evolutek/acdc/V1/Mechanic/Raspy Cam/27-1a.stp

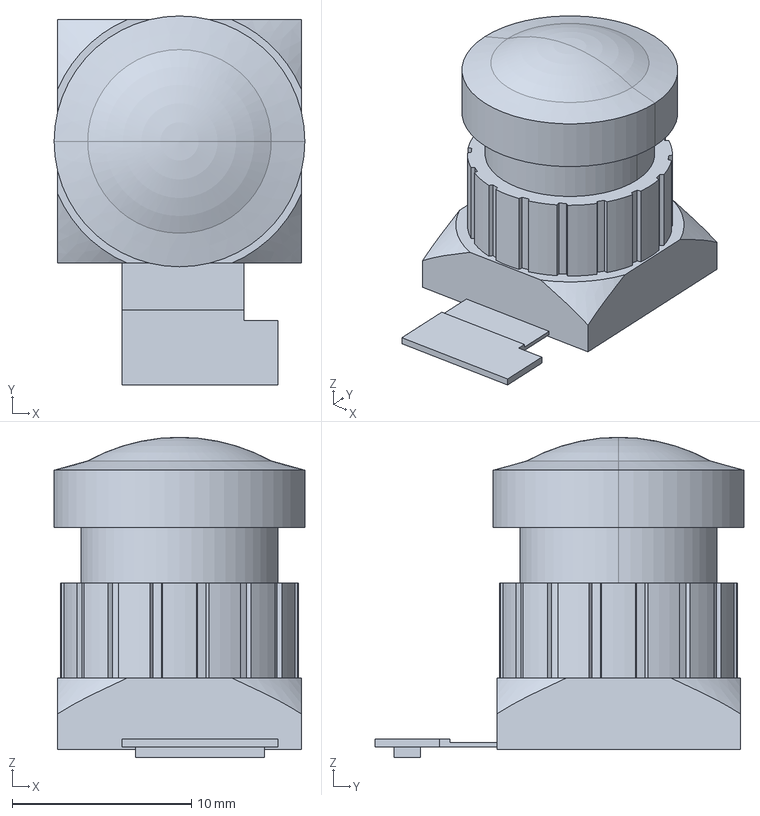
[picture p1: CAD file, 2023-09-23, an earlier design]
V1/Mechanic/Raspy Cam/27-1a.stp
14.0 x 20.6 x 17.9 mm
