evolutek/acdc/(list of files, cad)

Other CAD files:
V1/Mechanic/Camera GYTCARS.CATProduct
V1/Mechanic/Mainboard GYTCARS.CATProduct
V1/Mechanic/Mainboard/COMPOUND_1.CATPart
V1/Mechanic/Mainboard/COMPOUND_4.CATPart
V1/Mechanic/Mainboard/Mainboard GYTCARS V1.CATProduct
V1/Mechanic/Mainboard/SOLID.CATPart
V1/Mechanic/Mainboard/SOLID_1.CATPart
V1/Mechanic/Mainboard/SOLID_10.CATPart
V1/Mechanic/Mainboard/SOLID_11.CATPart
V1/Mechanic/Mainboard/SOLID_12.CATPart
V1/Mechanic/Mainboard/SOLID_2.CATPart
V1/Mechanic/Mainboard/SOLID_3.CATPart
V1/Mechanic/Mainboard/SOLID_4.CATPart
V1/Mechanic/Mainboard/SOLID_5.CATPart
V1/Mechanic/Mainboard/SOLID_6.CATPart
V1/Mechanic/Mainboard/SOLID_7.CATPart
V1/Mechanic/Mainboard/SOLID_8.CATPart
V1/Mechanic/Mainboard/SOLID_9.CATPart
V1/Mechanic/Raspy Cam/27-1.CATPart
V1/Mechanic/Raspy Cam/4pin_smd.CATPart
V1/Mechanic/Raspy Cam/70521906_01.CATPart
V1/Mechanic/Raspy Cam/70521906_02.CATPart
V1/Mechanic/Raspy Cam/70521906_03.CATPart
V1/Mechanic/Raspy Cam/70521906_04.CATPart
V1/Mechanic/Raspy Cam/70521906_05.CATPart
V1/Mechanic/Raspy Cam/70521906_06.CATPart
V1/Mechanic/Raspy Cam/70521906_07.CATPart
V1/Mechanic/Raspy Cam/CAPC-0402-T0.55-BN.CATPart
V1/Mechanic/Raspy Cam/CAPC-0805-T0.75-BN.CATPart
V1/Mechanic/Raspy Cam/CCD.CATPart
V1/Mechanic/Raspy Cam/KX7 SMD Quartz Crystal Resonator 3.2x2.5mm.CATPart
V1/Mechanic/Raspy Cam/OVA5647_Housing.CATPart
V1/Mechanic/Raspy Cam/OVA5647_Lens_FOV.CATPart
V1/Mechanic/Raspy Cam/PicameraPCB.CATPart
V1/Mechanic/Raspy Cam/RESC-0402.CATPart
V1/Mechanic/Raspy Cam/RESC-0603.CATPart
V1/Mechanic/Raspy Cam/RESC-1210.CATPart
V1/Mechanic/Raspy Cam/RspCameraMia.CATProduct
V1/Mechanic/Raspy Cam/SOT23-5.CATPart
V1/Mechanic/Raspy Cam/c-1-1734248-5-e-raspberry_display.CATPart
V1/Mechanic/Raspy Cam/c6aaa.CATPart
V1/Mechanic/Raspy Cam/ribbon_cam.CATPart
V1/Mechanic/Support Camera GYTCARS.CATPart
