evolutek/acdc/V2/DevBoard/Output/Schematics.pdf

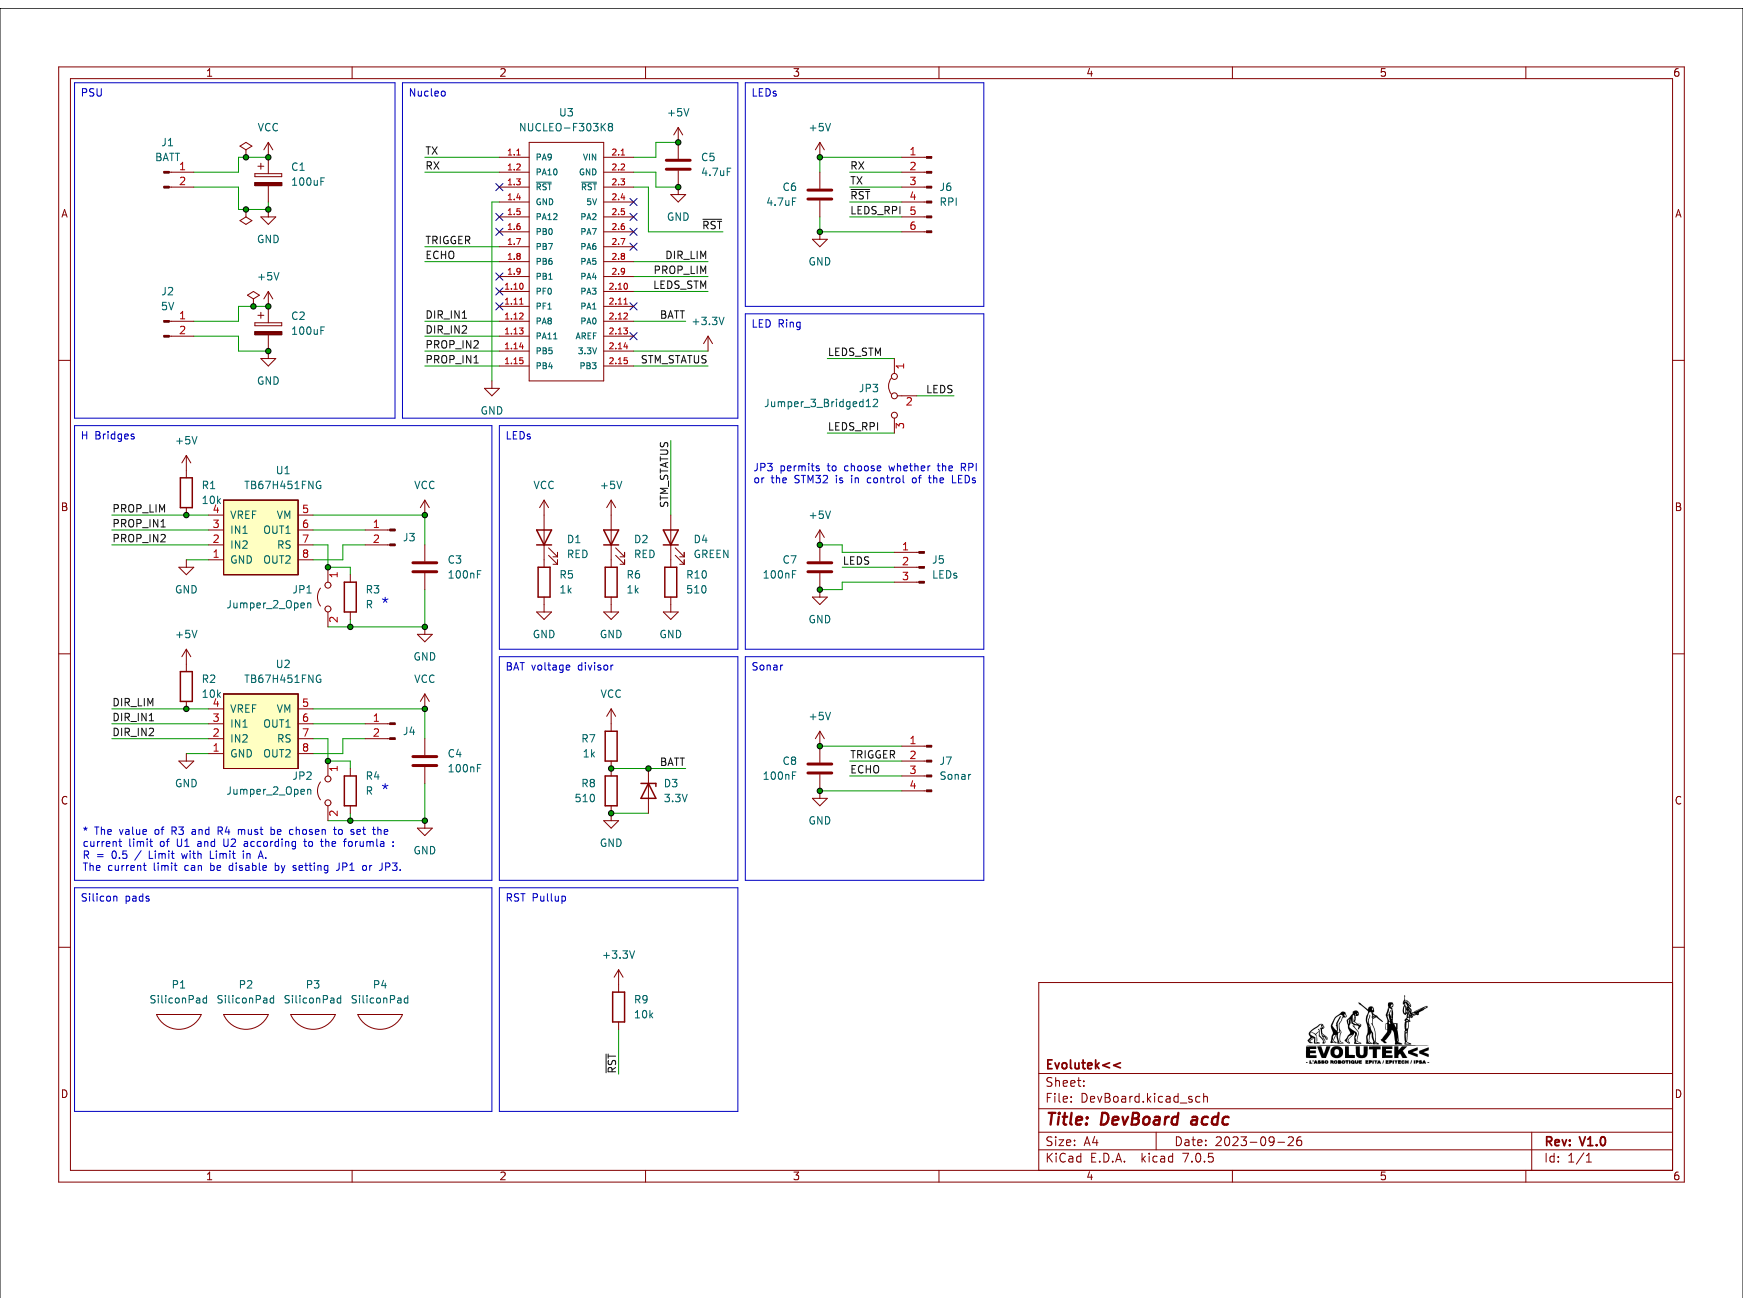
[picture p3: page 1]
