evolutek/acdc/V2/DevBoard/Output/Board-Front.pdf

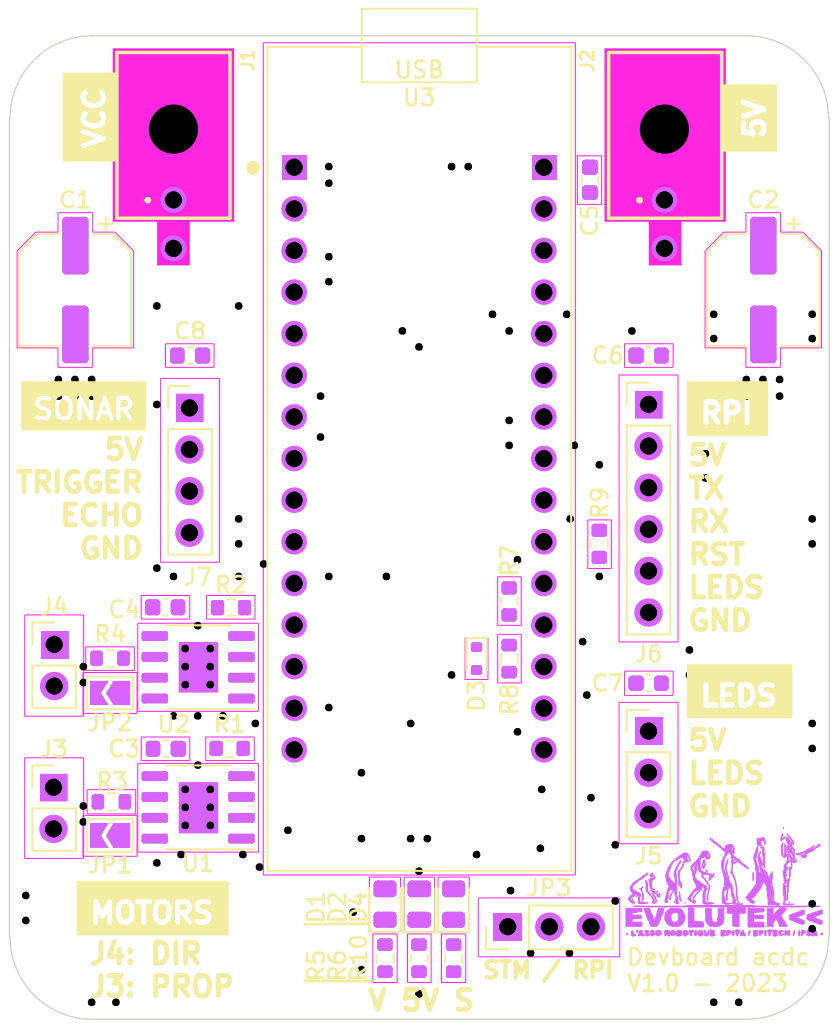
[picture p4: page 1]
