evolutek/acdc/V1/Board/Output/Schematics.pdf

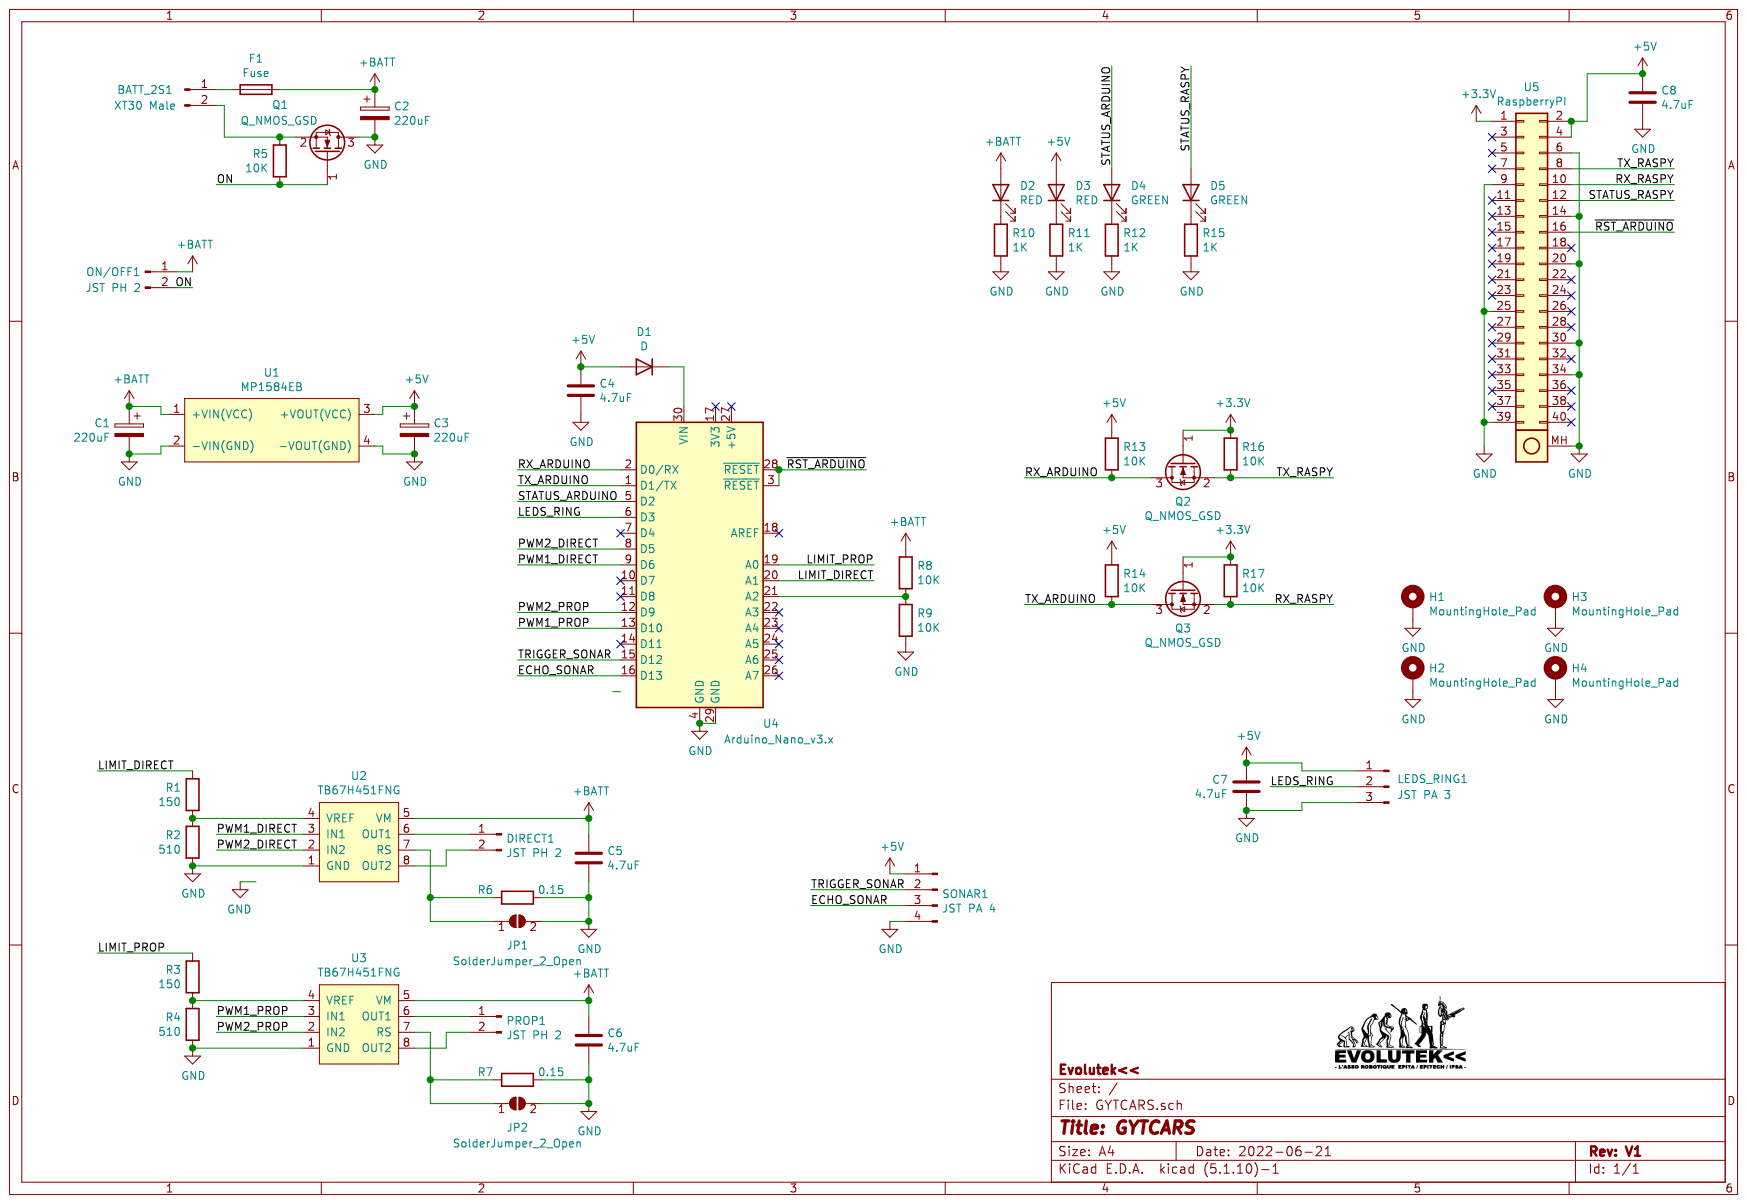
[picture p5: page 1]
