evolutek/acdc/V1/Board/Output/Board-Back.pdf

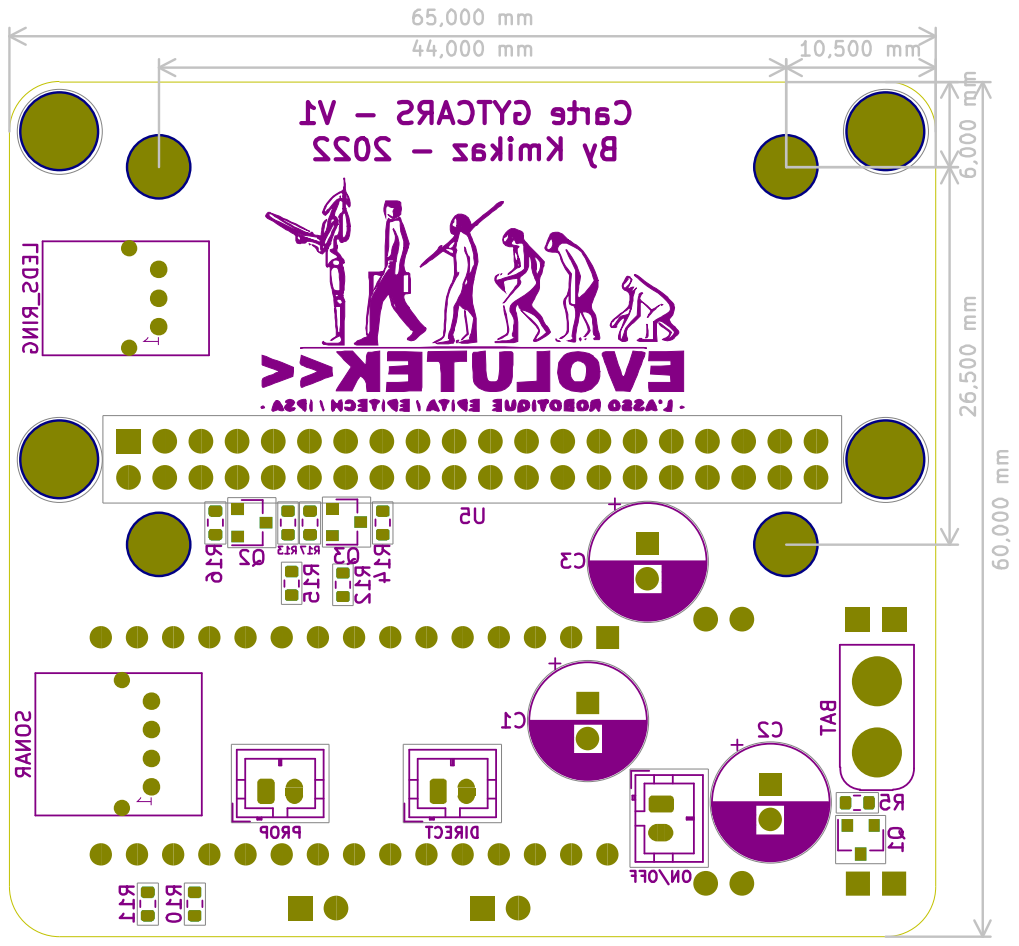
[picture p6: page 1]
