evolutek/acdc/V1/Board/Output/Board-Front.pdf

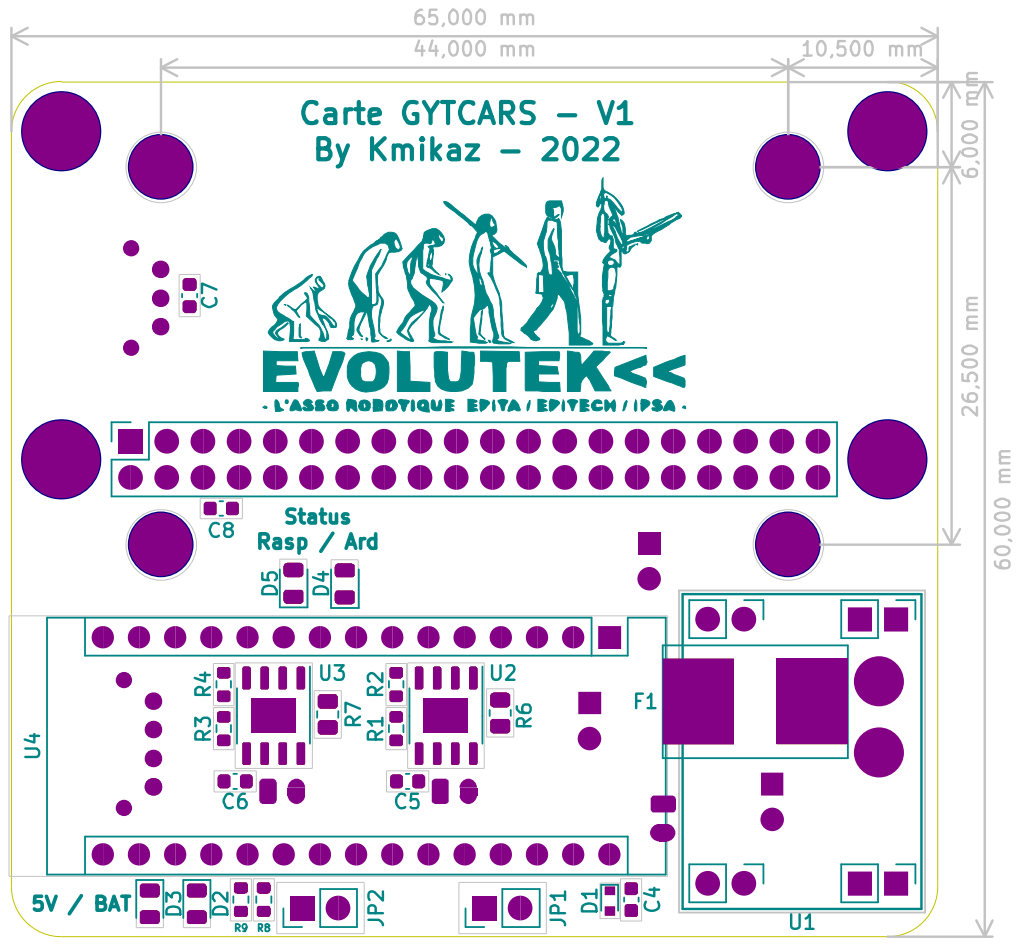
[picture p7: page 1]
