evolutek/acdc/V2/DevBoard/DevBoard.kicad_pcb

## KiCad design V2/DevBoard/DevBoard.kicad_pcb (2023-10-06)

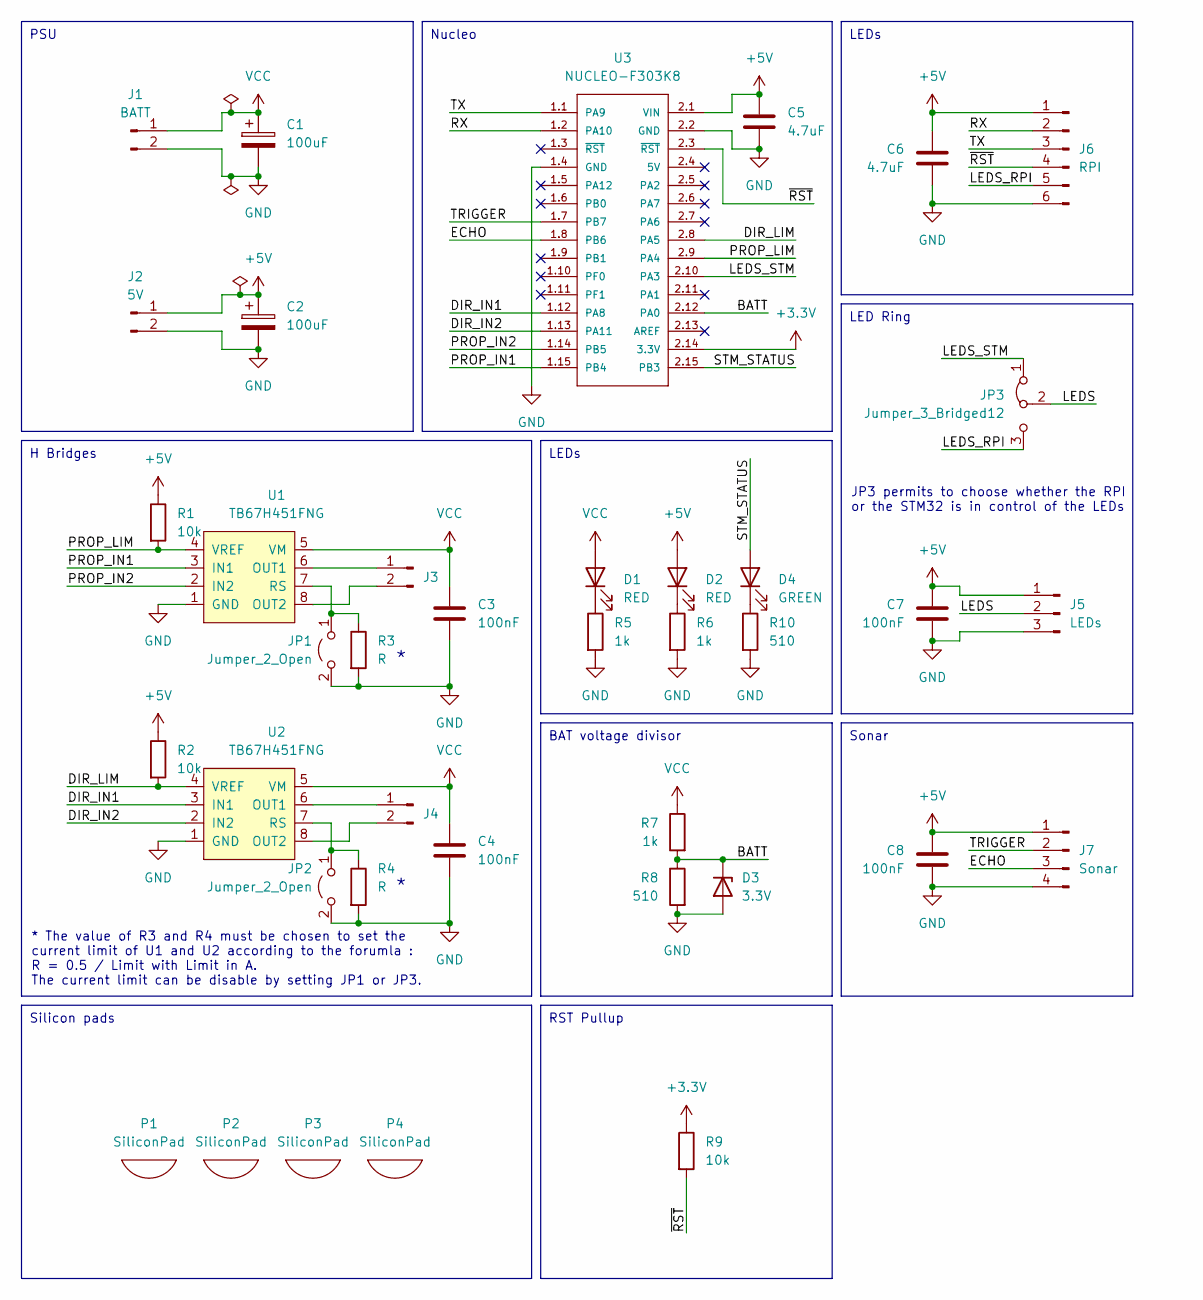
[picture p8: schematic DevBoard.kicad_sch, DevBoard acdc]

Parts:
C1, C2: 100uF; CP_Elec_6.3x7.7
C3, C4, C7, C8: 100nF; C_0603_1608Metric
C5, C6: 4.7uF; C_0603_1608Metric
D1, D2: RED; LED_0805_2012Metric
D3: 3.3V; D_SOD-523
D4: GREEN; LED_0805_2012Metric
J1: BATT; 66200221022
J2: 5V; 66200221022
J3, J4: Conn_01x02_Pin; PinHeader_1x02_P2.54mm_Vertical
J5: LEDs; PinHeader_1x03_P2.54mm_Vertical
J6: RPI; PinHeader_1x06_P2.54mm_Vertical
J7: Sonar; PinHeader_1x04_P2.54mm_Vertical
JP1, JP2: Jumper_2_Open; SolderJumper-2_P1.3mm_Open_TrianglePad1.0x1.5mm
JP3: Jumper_3_Bridged12; PinHeader_1x03_P2.54mm_Vertical
P1, P2, P3, P4: SiliconPad; Silicon Pad 6x2mm
R1, R2, R9: 10k; R_0603_1608Metric
R3, R4: R; R_0603_1608Metric
R5, R6, R7: 1k; R_0603_1608Metric
R8, R10: 510; R_0603_1608Metric
U1, U2: TB67H451FNG; HSOP-8-1EP_3.9x4.9mm_P1.27mm_EP2.41x3.1mm_ThermalVias
U3: NUCLEO-F303K8; MODULE_NUCLEO-F303K8

Connections:
+3.3V: R9.1, U3.2.14 (3.3V)
+5V: C2.1, C5.1, C6.1, C7.1, C8.1, D2.2 (A), J2.1, J5.1, J6.1, J7.1, R1.1, R2.1, U3.2.1 (VIN)
/BATT: D3.1 (K), R7.2, R8.1, U3.2.12 (PA0)
/DIR_IN1: U2.3 (IN1), U3.1.12 (PA8)
/DIR_IN2: U2.2 (IN2), U3.1.13 (PA11)
/DIR_LIM: R2.2, U2.4 (VREF), U3.2.8 (PA5)
/ECHO: J7.3, U3.1.8 (PB6)
/LEDS: J5.2, JP3.2 (C)
/LEDS_RPI: J6.5, JP3.3 (B)
/LEDS_STM: JP3.1 (A), U3.2.10 (PA3)
/PROP_IN1: U1.3 (IN1), U3.1.15 (PB4)
/PROP_IN2: U1.2 (IN2), U3.1.14 (PB5)
/PROP_LIM: R1.2, U1.4 (VREF), U3.2.9 (PA4)
/RX: J6.2, U3.1.2 (PA10)
/STM_STATUS: D4.2 (A), U3.2.15 (PB3)
/TRIGGER: J7.2, U3.1.7 (PB7)
/TX: J6.3, U3.1.1 (PA9)
/~RST: J6.4, R9.2, U3.2.3 (~RST)
GND: C1.2, C2.2, C3.2, C4.2, C5.2, C6.2, C7.2, C8.2, D3.2 (A), J1.2, J2.2, J5.3, J6.6, J7.4, JP1.2 (B), JP2.2 (B), R3.2, R4.2, R5.2, R6.2, R8.2, R10.2, U1.1 (GND), U2.1 (GND), U3.1.4 (GND), U3.2.2 (GND)
unnamed: D1.1 (K), R5.1
unnamed: D2.1 (K), R6.1
unnamed: D4.1 (K), R10.1
unnamed: J3.1, U1.6 (OUT1)
unnamed: J3.2, U1.8 (OUT2)
unnamed: J4.1, U2.6 (OUT1)
unnamed: J4.2, U2.8 (OUT2)
unnamed: JP1.1 (A), R3.1, U1.7 (RS)
unnamed: JP2.1 (A), R4.1, U2.7 (RS)
VCC: C1.1, C3.1, C4.1, D1.2 (A), J1.1, R7.1, U1.5 (VM), U2.5 (VM)

Notes on the sheet:
LEDs
H Bridges
Sonar
PSU
Silicon pads
Nucleo
BAT voltage divisor
LED Ring
RST Pullup
JP3 permits to choose whether the RPI or the STM32 is in control of the LEDs
* The value of R3 and R4 must be chosen to set the current limit of U1 and U2 according to the forumla : R = 0.5 / Limit with Limit in A. The current limit can be disable by setting JP1 or JP3.

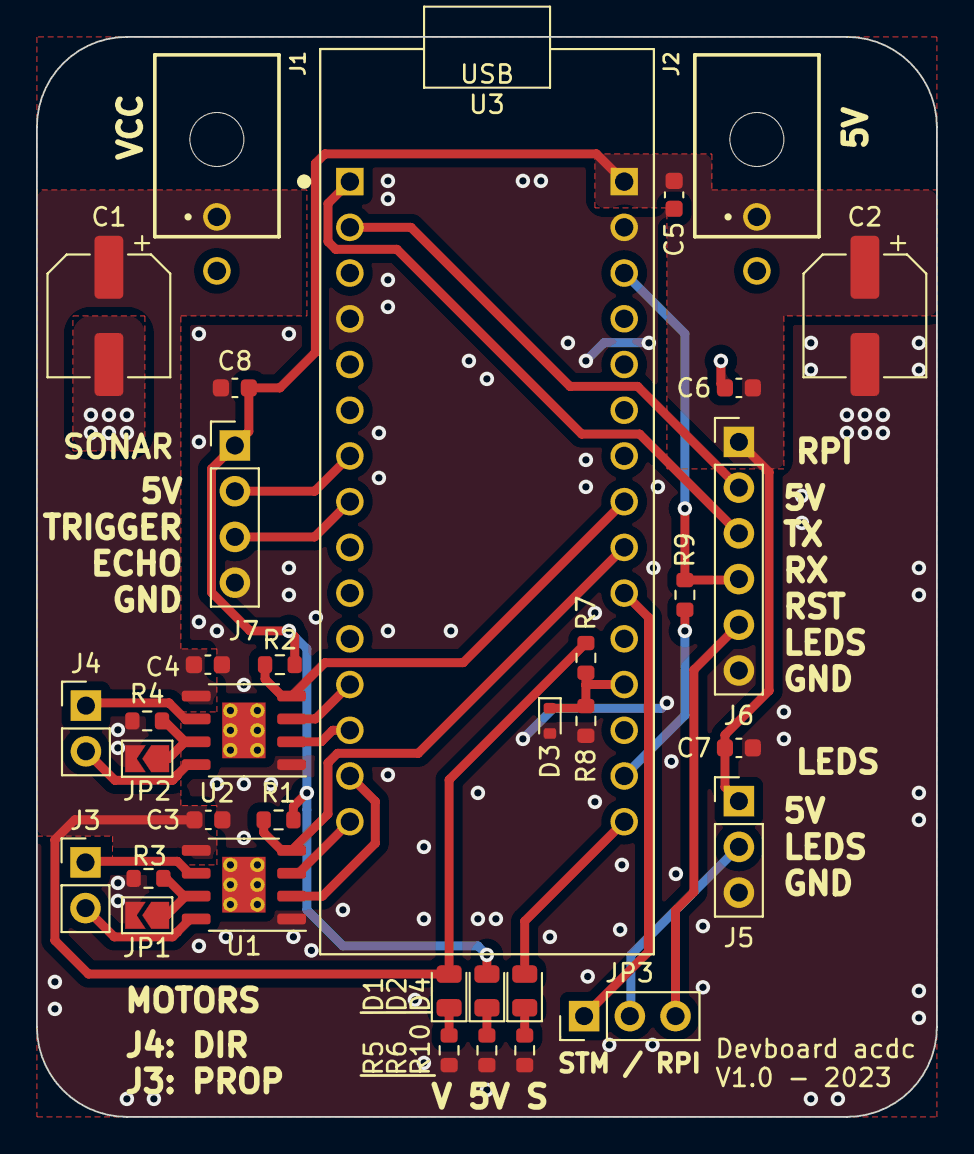
[picture p9: board DevBoard.kicad_pcb from above]

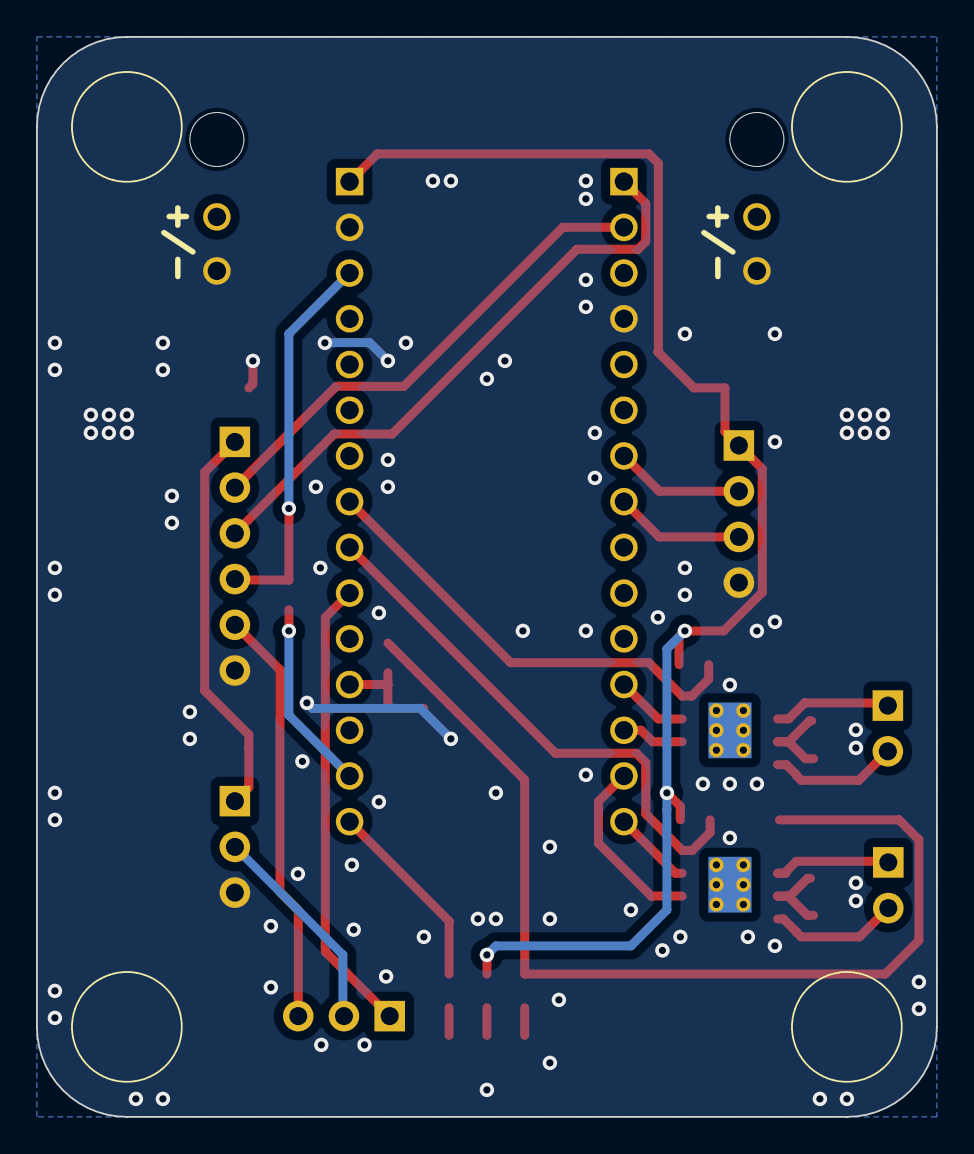
[picture p10: board DevBoard.kicad_pcb from below]

Board: 2 copper layers, 50.0 x 60.0 mm, 39 parts (4 on the bottom side), 29 nets.
