evolutek/acdc/V1/Board/GYTCARS.kicad_pcb

## KiCad design V1/Board/GYTCARS.kicad_pcb (2022-06-21, an earlier design)

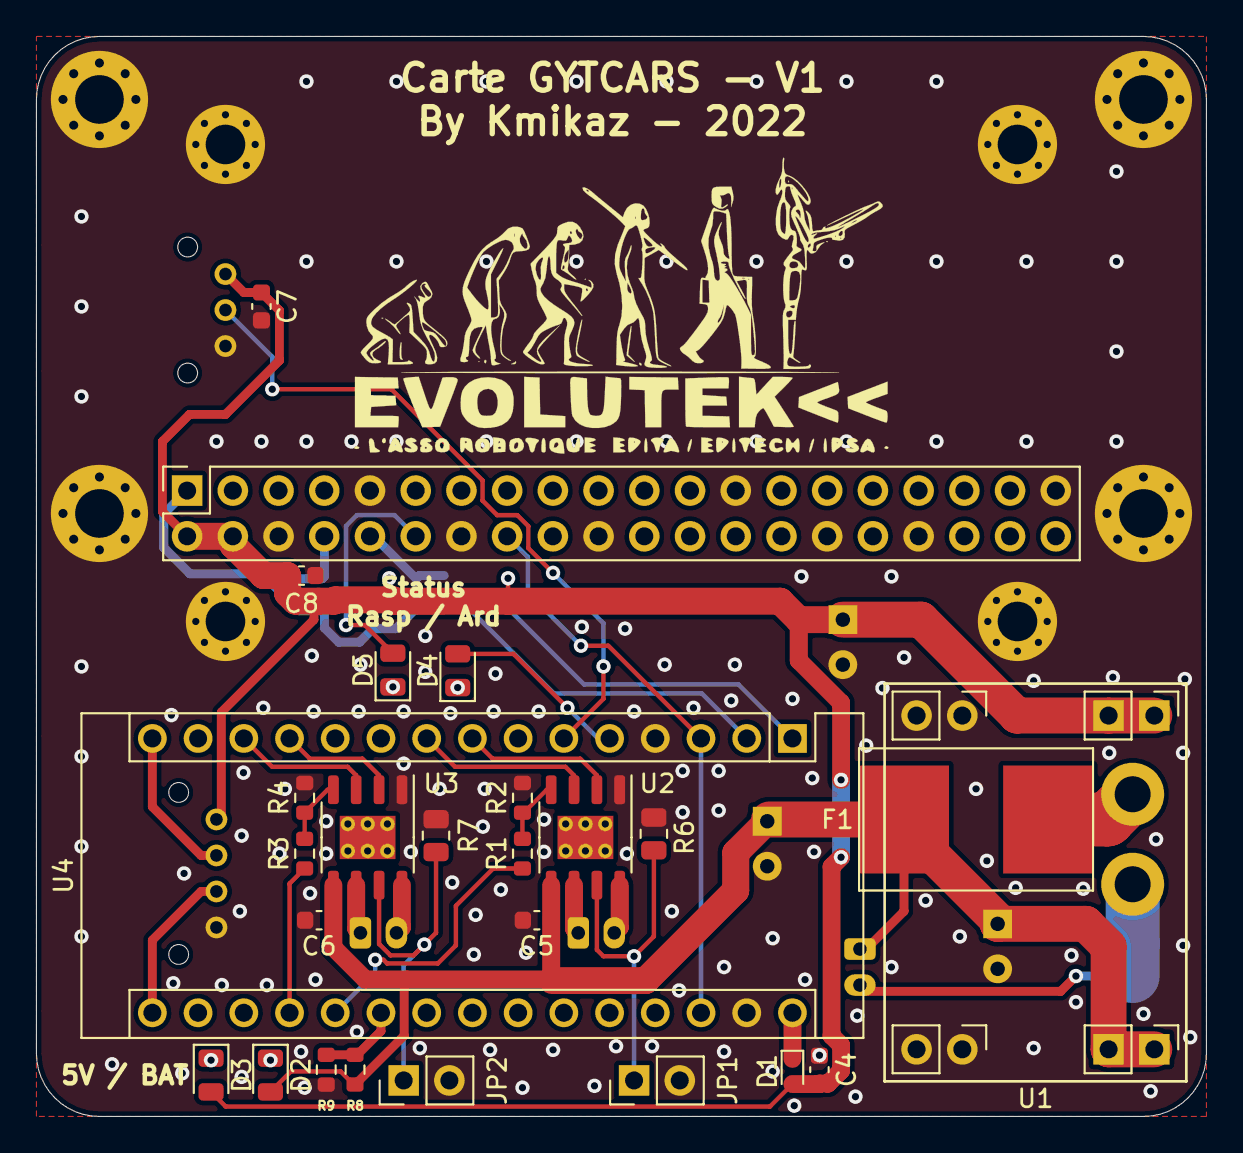
[picture p11: board GYTCARS.kicad_pcb from above]

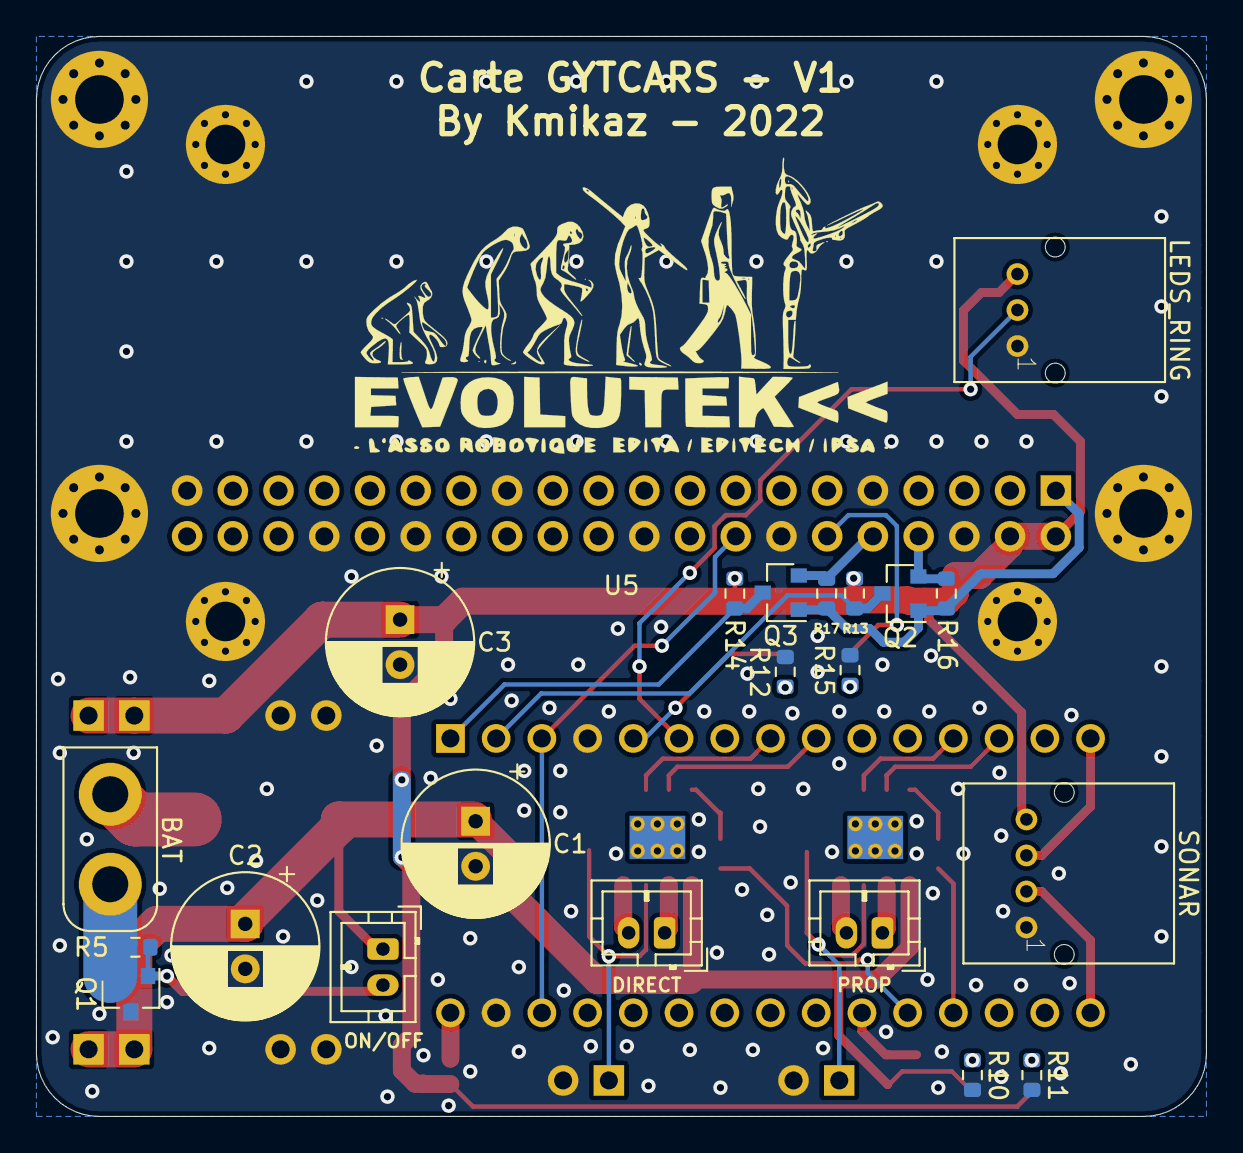
[picture p12: board GYTCARS.kicad_pcb from below]

Board: 2 copper layers, 65.0 x 60.0 mm, 51 parts (22 on the bottom side), 37 nets.

Parts:
BAT: XT30 Male; XT30
C1, C2, C3: 220uF; CP_Radial_D8.0mm_P2.50mm
C4, C5, C6, C7, C8: 4.7uF; C_0603_1608Metric
D1: D; D_SOD-523
D2, D3: RED; LED_0805_2012Metric
D4, D5: GREEN; LED_0805_2012Metric
DIRECT: JST PH 2; JST_PH_B2B-PH-K_1x02_P2.00mm_Vertical
F1: Fuse; 0031.7701.11
H1, H2, H3, H4: MountingHole_Pad; MountingHole_2.2mm_M2_Pad_Via
JP1, JP2: SolderJumper_2_Open; PinHeader_1x02_P2.54mm_Vertical
LEDS_RING: JST PA 3; S03B-PASK
ON/OFF: JST PH 2; JST_PH_B2B-PH-K_1x02_P2.00mm_Vertical
PROP: JST PH 2; JST_PH_B2B-PH-K_1x02_P2.00mm_Vertical
Q1, Q2, Q3: Q_NMOS_GSD; SOT-23
R1, R3: 150; R_0603_1608Metric
R2, R4: 510; R_0603_1608Metric
R5, R8, R9, R13, R14, R16, R17: 10K; R_0603_1608Metric
R6, R7: 0.15; R_0805_2012Metric
R10, R11, R12, R15: 1K; R_0603_1608Metric
SONAR: JST PA 4; S04B-PASK
U1: MP1584EB; MP1584EN
U2, U3: TB67H451FNG; HSOP-8-1EP_3.9x4.9mm_P1.27mm_EP2.41x3.1mm_ThermalVias
U4: Arduino_Nano_v3.x; ArduinoNano
U5: RaspberryPI; Shield_Raspberry_Pi_Zero_W

Connections:
+3V3: Q2.1, Q3.1, R16.1, R17.1, U5.1
+5V: C3.1, C4.1, C7.1, C8.1, D1.2, D3.2, LEDS_RING.1, R13.1, R14.1, SONAR.1, U1.3, U5.2, U5.4
+BATT: C1.1, C2.1, C5.1, C6.1, D2.2, F1.1, ON/OFF.1, R8.1, U1.1, U2.5, U3.5
/ECHO_SONAR: SONAR.3, U4.16
/LEDS_RING: LEDS_RING.2, U4.6
/LIMIT_DIRECT: R1.1, U4.20
/LIMIT_PROP: R3.1, U4.19
/ON: ON/OFF.2, Q1.1, R5.2
/PWM1_DIRECT: U2.3, U4.9
/PWM1_PROP: U3.3, U4.13
/PWM2_DIRECT: U2.2, U4.8
/PWM2_PROP: U3.2, U4.12
/RX_ARDUINO: Q2.3, R13.2, U4.2
/RX_RASPY: Q3.2, R17.2, U5.10
/STATUS_ARDUINO: D4.2, U4.5
/STATUS_RASPY: D5.2, U5.12
/TRIGGER_SONAR: SONAR.2, U4.15
/TX_ARDUINO: Q3.3, R14.2, U4.1
/TX_RASPY: Q2.2, R16.2, U5.8
/~RST_ARDUINO: U4.3, U4.28, U5.16
GND: C1.2, C2.2, C3.2, C4.2, C5.2, C6.2, C7.2, C8.2, H1.1, H2.1, H3.1, H4.1, JP1.2, JP2.2, LEDS_RING.3, Q1.3, R2.2, R4.2, R6.2, R7.2, R9.2, R10.2, R11.2, R12.2, R15.2, SONAR.4, U1.2, U1.4, U2.1, U3.1, U4.4, U4.29, U5.6, U5.9, U5.14, U5.20, U5.25, U5.30, U5.34, U5.39, U5.MH
unnamed: BAT.1, F1.2
unnamed: BAT.2, Q1.2, R5.1
unnamed: D1.1, U4.30
unnamed: D2.1, R10.1
unnamed: D3.1, R11.1
unnamed: D4.1, R12.1
unnamed: D5.1, R15.1
unnamed: DIRECT.1, U2.6
unnamed: DIRECT.2, U2.8
unnamed: JP1.1, R6.1, U2.7
unnamed: JP2.1, R7.1, U3.7
unnamed: PROP.1, U3.6
unnamed: PROP.2, U3.8
unnamed: R1.2, R2.1, U2.4
unnamed: R3.2, R4.1, U3.4
unnamed: R8.2, R9.1, U4.21
