evolutek/acdc/V2/Firmware-stm32/Core/Inc/main.h

#define BATT_Pin GPIO_PIN_0
#define BATT_GPIO_Port GPIOA
#define VCP_TX_Pin GPIO_PIN_2
#define VCP_TX_GPIO_Port GPIOA
#define LEDS_Pin GPIO_PIN_3
#define LEDS_GPIO_Port GPIOA
#define PROP_LIM_Pin GPIO_PIN_4
#define PROP_LIM_GPIO_Port GPIOA
#define DIR_LIM_Pin GPIO_PIN_5
#define DIR_LIM_GPIO_Port GPIOA
#define DIR_IN1_Pin GPIO_PIN_8
#define DIR_IN1_GPIO_Port GPIOA
#define TX_Pin GPIO_PIN_9
#define TX_GPIO_Port GPIOA
#define RX_Pin GPIO_PIN_10
#define RX_GPIO_Port GPIOA
#define DIR_IN2_Pin GPIO_PIN_11
#define DIR_IN2_GPIO_Port GPIOA
#define SWDIO_Pin GPIO_PIN_13
#define SWDIO_GPIO_Port GPIOA
#define SWCLK_Pin GPIO_PIN_14
#define SWCLK_GPIO_Port GPIOA
#define VCP_RX_Pin GPIO_PIN_15
#define VCP_RX_GPIO_Port GPIOA
#define STATUS_LED_Pin GPIO_PIN_3
#define STATUS_LED_GPIO_Port GPIOB
#define PROP_IN1_Pin GPIO_PIN_4
#define PROP_IN1_GPIO_Port GPIOB
#define PROP_IN2_Pin GPIO_PIN_5
#define PROP_IN2_GPIO_Port GPIOB
#define ECHO_Pin GPIO_PIN_6
#define ECHO_GPIO_Port GPIOB
#define TRIGGER_Pin GPIO_PIN_7
#define TRIGGER_GPIO_Port GPIOB
