evolutek/acdc/(commit log)

2022-06-15 wip schematics
    [GYTCARS.kicad_pcb, GYTCARS.sch]
2022-06-17 [FIX] Left a useless line causing a crash, also added the print of the script version
2022-06-21 First version of the board
    [GYTCARS.kicad_pcb, GYTCARS.sch]
2022-06-24 Wip Arduino Firmware
2022-06-26 Add get voltage command
2022-06-27 Manage motor current limit and fix some minor bugs
    [arduino-firmware.ino]
2022-06-27 [FIX] correction of return
    [protocol.py]
2022-06-27 [FIX] del angle enum
    [Response.py]
2022-06-27 [FIX] name of enum
    [protocol.py]
2022-06-28 First version of the mechanical improvements of the car
    [27-1.CATPart, 27-1a.stp, 4pin_smd.CATPart, 70521906_01.CATPart, 70521906_02.CATPart, 70521906_03.CATPart, 70521906_04.CATPart, 70521906_05.CATPart]
2023-09-23 Put V1 in subfolder
    [27-1.CATPart, 27-1a.stp, 4pin_smd.CATPart, 70521906_01.CATPart, 70521906_02.CATPart, 70521906_03.CATPart, 70521906_04.CATPart, 70521906_05.CATPart]
2023-09-23 WIP devboard for V2
    [DevBoard.kicad_pcb, DevBoard.kicad_sch]
2023-09-25 Add STM32 Firmware
2023-09-25 WIP DevBoard
    [DevBoard.kicad_sch]
2023-10-06 Devboard completed
    [Board.kicad_pcb, Board.kicad_sch, DevBoard.kicad_pcb, DevBoard.kicad_sch]
2023-10-06 Fix mapping in stm32 project
    [Firmware-stm32.ioc, main.h]
